sidneygasoto/QIDI-XPRO-Rebuild/05_Metrology/source/CONTINUE.md

# Development Rules

- Analyze the architecture before editing.
- Keep changes minimal.
- Avoid duplicated code.
- Prefer existing abstractions.
- Do not modify public APIs without justification.
- Update documentation when behavior changes.
- Keep compatibility with Klipper.
