sidneygasoto/QIDI-XPRO-Rebuild/08_Fotos/Bed_Level_numerado.png

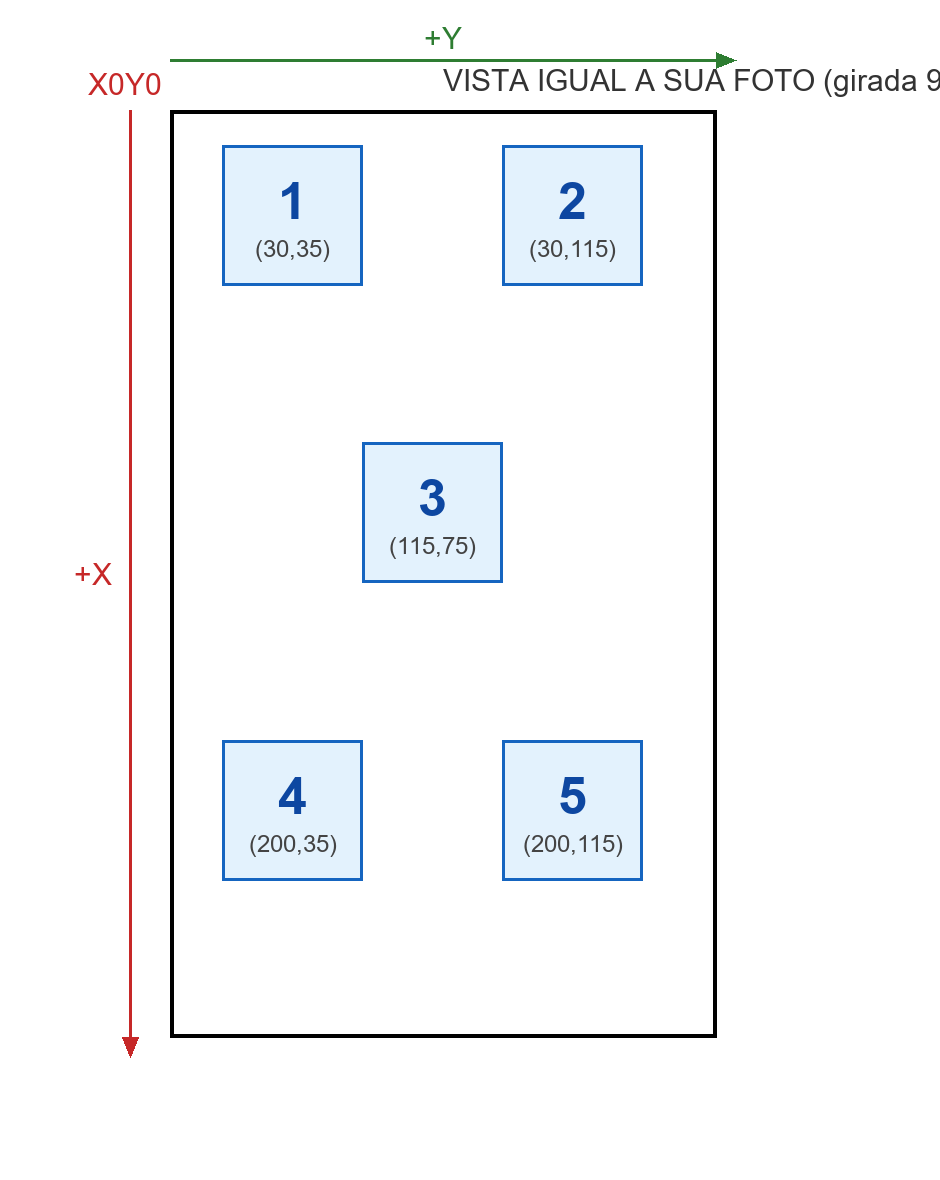
08_Fotos/Bed_Level_numerado.png
