sidneygasoto/QIDI-XPRO-Rebuild/08_Fotos/Diag pin.jpeg

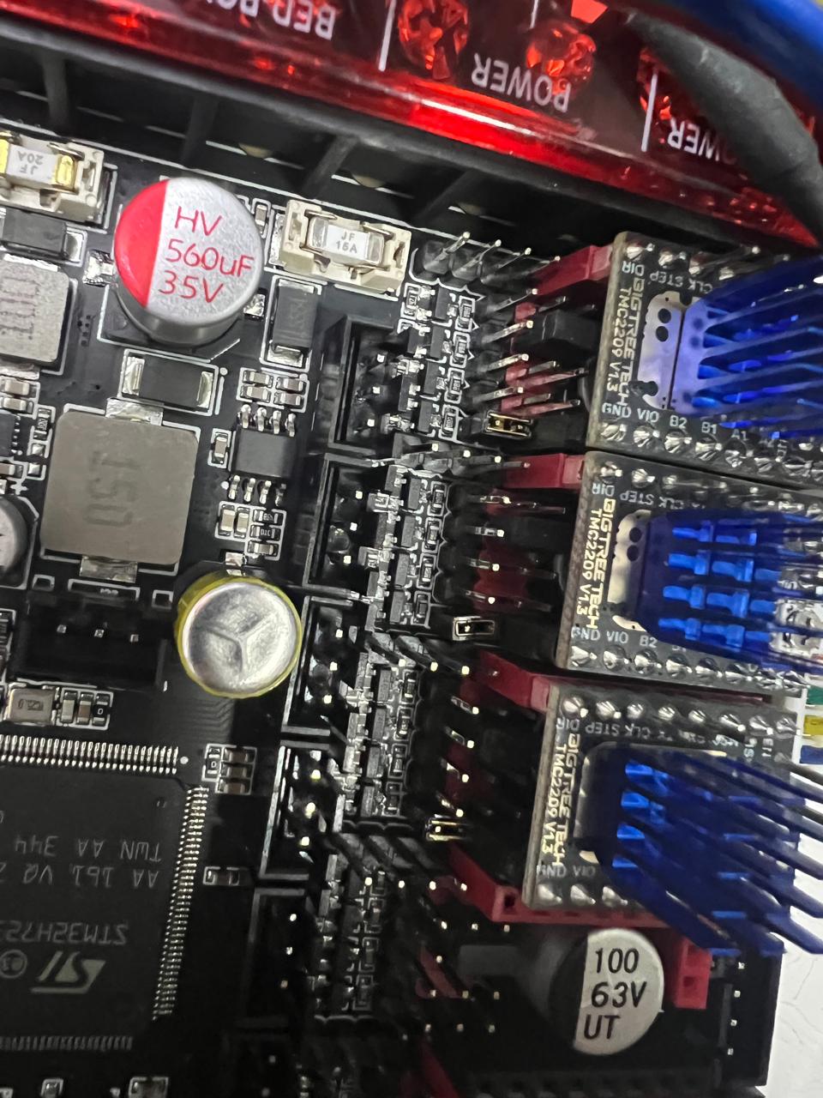
08_Fotos/Diag pin.jpeg
