sidneygasoto/QIDI-XPRO-Rebuild/08_Fotos/MB_BTT_CB1_detalhe.jpeg

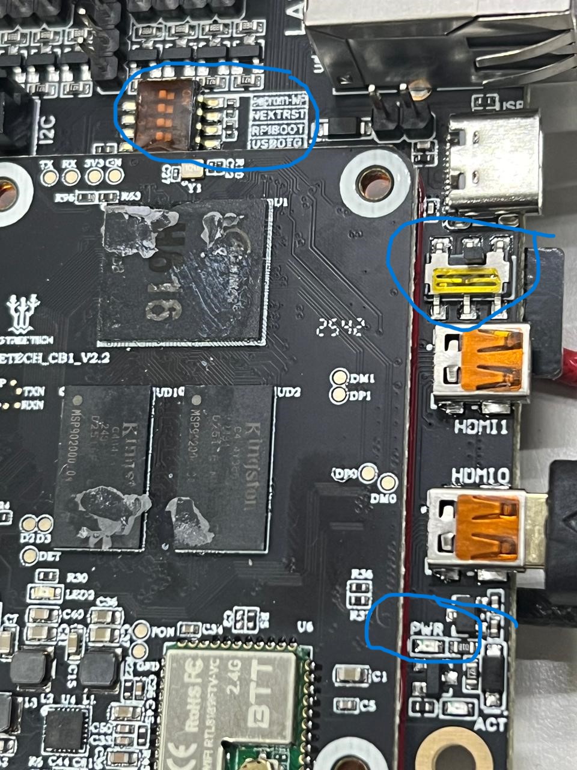
08_Fotos/MB_BTT_CB1_detalhe.jpeg
