sidneygasoto/QIDI-XPRO-Rebuild/04_STL/Nozzle temperature test.3mf

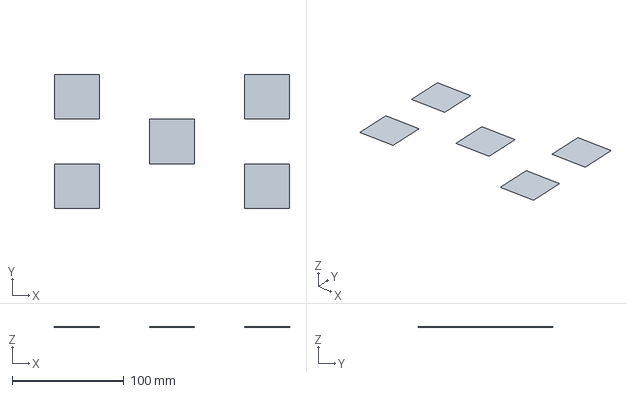
[picture p6: CAD file, 2026-10-27]
04_STL/Nozzle temperature test.3mf
210.0 x 120.0 x 0.2 mm
