sidneygasoto/QIDI-XPRO-Rebuild/04_STL/Bed_Level_1x40x40_0.2mm.stl

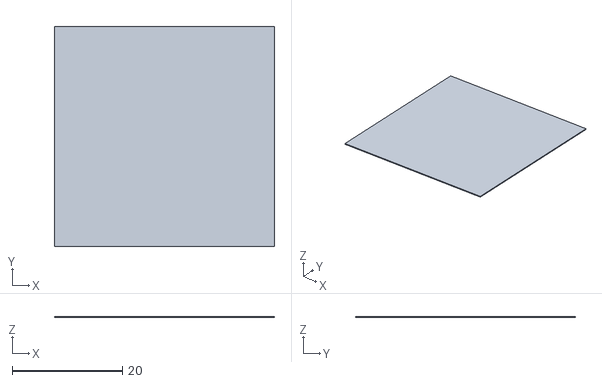
[picture p7: CAD file, 2026-10-26]
04_STL/Bed_Level_1x40x40_0.2mm.stl
40.0 x 40.0 x 0.2
