sidneygasoto/QIDI-XPRO-Rebuild/(list of files, cad)

Other CAD files:
04_STL/Bed_Level_5x40x40_0.2mm.stl
