sidneygasoto/QIDI-XPRO-Rebuild/13_Camera/04_Testing.md

# Testes

## Objetivo

Registrar os testes executados durante a implantação da câmera, bem como os respectivos resultados e validações.

---

## Conteúdo

Esta etapa documentará:

- Testes de compilação;
- Testes de inicialização;
- Testes do serviço;
- Testes de integração;
- Testes de streaming;
- Validação final.

---

## Status

> Em desenvolvimento.
