sidneygasoto/QIDI-XPRO-Rebuild/03_Klipper_Config/printer.cfg

########################################
# QIDI X-Pro Retrofit
# BIGTREETECH Manta M8P V2.0
# Klipper
########################################


########################################
# Includes
########################################

[include fluidd.cfg]
[include qidi_xpro/steppers.cfg]
[include qidi_xpro/tmc2209.cfg]
[include qidi_xpro/extruders.cfg]
[include qidi_xpro/heaters.cfg]
[include qidi_xpro/fans.cfg]
[include qidi_xpro/adxl345.cfg]
[include qidi_xpro/tools.cfg]
[include qidi_xpro/macros.cfg]
[include qidi_xpro/lights.cfg]
[include qidi_xpro/probe.cfg]
[include qidi_xpro/bed_mesh.cfg]
[include qidi_xpro/power.cfg]
[include qidi_xpro/filament.cfg]
#[include qidi_xpro/metrology.cfg]

[exclude_object]

########################################
# MCU
########################################

[mcu]
serial: /dev/serial/by-id/usb-Klipper_stm32h723xx_34002F000A51333231343036-if00

########################################
# Printer
########################################

[printer]

kinematics: cartesian

max_velocity: 600
max_accel: 10000

max_z_velocity: 25
max_z_accel: 1000

[extruder1]
#control: pid
#pid_Kp: 23.451
#pid_Ki: 1.839
#pid_Kd: 74.751

[heater_bed]
#control: pid
#pid_Kp: 73.294
#pid_Ki: 3.152
#pid_Kd: 426.020

[include moonraker_obico_macros.cfg]

#*# <---------------------- SAVE_CONFIG ---------------------->
#*# DO NOT EDIT THIS BLOCK OR BELOW. The contents are auto-generated.
#*#
#*# [input_shaper]
#*# shaper_type_x = 3hump_ei
#*# shaper_freq_x = 67.2
#*# shaper_type_y = ei
#*# shaper_freq_y = 37.2
#*#
#*# [extruder]
#*# control = pid
#*# pid_kp = 25.531
#*# pid_ki = 2.659
#*# pid_kd = 61.274
#*#
#*# [extruder1]
#*# control = pid
#*# pid_kp = 24.271
#*# pid_ki = 1.881
#*# pid_kd = 78.275
#*#
#*# [heater_bed]
#*# control = pid
#*# pid_kp = 72.591
#*# pid_ki = 3.361
#*# pid_kd = 391.989
#*#
#*# [probe]
#*# z_offset = 0.900
#*#
#*# [bed_mesh default]
#*# version = 1
#*# points =
#*# 	  -0.540000, -0.395000, -0.317500, -0.330000, -0.202500, -0.235000, -0.325000
#*# 	  -0.492500, -0.347500, -0.280000, -0.192500, -0.192500, -0.220000, -0.235000
#*# 	  -0.540000, -0.402500, -0.280000, -0.302500, -0.185000, -0.232500, -0.310000
#*# 	  -0.550000, -0.420000, -0.340000, -0.222500, -0.222500, -0.245000, -0.285000
#*# 	  -0.657500, -0.485000, -0.350000, -0.360000, -0.237500, -0.257500, -0.392500
#*# x_count = 7
#*# y_count = 5
#*# mesh_x_pps = 2
#*# mesh_y_pps = 2
#*# algo = bicubic
#*# tension = 0.2
#*# min_x = 40.0
#*# max_x = 253.0
#*# min_y = 30.0
#*# max_y = 154.0
