sidneygasoto/QIDI-XPRO-Rebuild/03_Klipper_Config/qidi_xpro/tmc2209.cfg

########################################
# QIDI X-Pro Retrofit
# TMC2209 UART Configuration
# BIGTREETECH Manta M8P V2.0
########################################


[tmc2209 stepper_x]
uart_pin: PC13
run_current: 0.700
hold_current: 0.250
stealthchop_threshold: 999999
#stealthchop_threshold: 0
#diag_pin: PF4
#driver_SGTHRS: 55

[tmc2209 stepper_y]
uart_pin: PE3
run_current: 0.700
hold_current: 0.250
stealthchop_threshold: 999999
#stealthchop_threshold: 0
#diag_pin: PF3
#driver_SGTHRS: 60

[tmc2209 stepper_z]
uart_pin: PB9
run_current: 0.650
hold_current: 0.200
stealthchop_threshold: 999999

[tmc2209 extruder]
uart_pin: PB5
run_current: 0.600
hold_current: 0.250
stealthchop_threshold: 0


[tmc2209 extruder1]
uart_pin: PG14
run_current: 0.600
hold_current: 0.250
stealthchop_threshold: 0
