sidneygasoto/QIDI-XPRO-Rebuild/03_Klipper_Config/qidi_xpro/probe.cfg

########################################
# AECO M8 PNP Probe
########################################

[probe]
pin: ^PD8

# Ajustaremos depois
x_offset: 18
y_offset: 11
#z_offset: 0.205

speed: 5

samples: 5
samples_result: median

samples_tolerance: 0.030
samples_tolerance_retries: 3

sample_retract_dist: 3

lift_speed: 15
