sidneygasoto/QIDI-XPRO-Rebuild/03_Klipper_Config/fluidd.cfg

########################################
# Fluidd Support
########################################

[virtual_sdcard]
path: /opt/3dprinter/printer_data/gcodes

[pause_resume]

[display_status]

[gcode_macro CANCEL_PRINT]
description: Cancel the current print
rename_existing: BASE_CANCEL_PRINT
gcode:
    TURN_OFF_HEATERS
    CLEAR_PAUSE
    SDCARD_RESET_FILE
    BASE_CANCEL_PRINT
