sidneygasoto/QIDI-XPRO-Rebuild/03_Klipper_Config/qidi_xpro/fans.cfg

########################################
# QIDI X-Pro Retrofit
# Fans Configuration
# BIGTREETECH Manta M8P V2.0
########################################


########################################
# Part Cooling Fan
########################################
[fan]
pin: PF6

########################################
# Hotend 0 Cooling Fan
########################################
[heater_fan hotend_fan_0]
pin: PF7
heater: extruder
heater_temp: 50.0

########################################
# Hotend 1 Cooling Fan
########################################
[heater_fan hotend_fan_1]
pin: PF9
heater: extruder1
heater_temp: 50.0
