sidneygasoto/QIDI-XPRO-Rebuild/07_Backup/config_2026-07-28_v0.2.5/machine-snapshot/qidi_xpro/tools.cfg

[gcode_macro T0]
gcode:
    ACTIVATE_EXTRUDER EXTRUDER=extruder
    SET_GCODE_OFFSET X=0 Y=0 Z=0

[gcode_macro T1]
gcode:
    ACTIVATE_EXTRUDER EXTRUDER=extruder1
    SET_GCODE_OFFSET X=33.600 Y=-0.640 Z=-0.080
