sidneygasoto/QIDI-XPRO-Rebuild/(commit log)

2026-07-07 docs: add initial project documentation and Backup_0
    [generic-bigtreetech-manta-m8p-V2_0.cfg]
2026-07-09 Atualização de docs
2026-07-09 Add validated Klipper configuration and Manta firmware artifacts
    [extruders.cfg, fans.cfg, heaters.cfg, printer.cfg, steppers.cfg, tmc2209.cfg]
2026-07-09 v0.2.0 complete Klipper Moonraker Fluidd stack
2026-07-21 v0.1.0 - Base funcional do retrofit QIDI X-Pro
    [adxl345.cfg, extruders.cfg, fans.cfg, heaters.cfg, printer.cfg, probe.cfg, steppers.cfg, tmc2209.cfg]
2026-07-24 docs(camera): add camera-streamer documentation structure
2026-07-24 docs(camera): document camera-streamer systemd service
2026-07-28 v0.2.0 - Machine geometry and dual nozzle calibration
    [adxl345.cfg, extruders.cfg, fans.cfg, fluidd.cfg, heaters.cfg, metrology.cfg, printer.cfg, probe.cfg]
2026-10-25 docs(v0.3.0): consolidar configuração real e estado verificado da máquina
    - espelha a configuração ativa da CB1 em 03_Klipper_Config/ (15 arquivos + MANIFEST)
    - move a árvore pré-calibração para 07_Backup/config_v0.1.0_2026-07/
    - recupera a árvore de cb7f9fc em 07_Backup/config_v0.2.5_2026-07-28/
    - preserva a extensão de metrologia e a proveniência em 05_Metrology/
    - reescreve 00_Estado_Atual, CHANGELOG, releases, README e Roadmap como v0.3.0
    - adiciona .gitattributes para evitar conversão de EOL nas configs espelhadas
2026-10-25 chore(gitignore): corrigir padrão de ignore do 12_BKP_chat
    O padrão anterior (.12_BKP_chat/) exigia um arquivo com ponto inicial e não ignorava nada. Agora 12_BKP_chat/ é efetivamente ignorado e *.swp vindo do remoto foi preservado.
2026-10-25 chore(backup): consolidar snapshots de julho e corrigir EOL
    - unifica config_v0.2.5_2026-07-28 e config_v0.2.0 em
    07_Backup/config_2026-07-28_v0.2.5/{commit-tree,machine-snapshot}
    - reconstrói os snapshots a partir dos blobs do git com core.autocrlf=false:
    as cópias anteriores estavam em CRLF e não eram fiéis ao commit
    - verifica fidelidade por git hash-object contra os blobs de origem
    - atualiza as referências de caminho em 00_Estado_Atual e CHANGELOG
2026-10-25 docs(mesh): registrar diagnóstico do bed mesh e corrigir afirmação sobre limites
    - adiciona 01_Docs/07_Bed_Mesh.md com a análise geométrica do perfil salvo
    - corrige a alegação de que mesh_max excedia position_max: mesh_min/max são
    coordenadas da sonda (bed_mesh.py:824 e probe.py:474), não do bico
    - registra que o perfil está inerte (sem BED_MESH* nos logs) e vencido
    (anterior ao re-nivelamento mecânico da mesa)
    - atualiza referências em 00_Estado_Atual, Roadmap, 03_Klipper_Config e PROVENANCE
2026-10-25 fix(mesh): recalibrar a malha a quente e corrigir limites da sonda
    - PROBE_ACCURACY: faixa 12,5 um (sigma 3,7 um); samples_tolerance 0.010 -> 0.030
    - borda Y mapeada: a sonda deixa a chapa entre 157 e 161; mesh_max 165 -> 154
    - malha refeita 7x5 com mesh_max 253,154 e gravada em SAVE_CONFIG
    - amplitude 0,988 -> 0,417 mm; inclinacao Y 0,534 -> 0,134 mm/100 mm
    - espelho da configuracao e MANIFEST atualizados (15/15 conferem)
2026-10-26 fix(probe): revalidar z_offset com papel e aplicar a malha no PRINT_START
    - PROBE_CALIBRATE a 80 C: z_offset 0,652 -> 0,515 mm (primeira camada
    vinha 0,137 mm baixa desde o re-nivelamento)
    - malha refeita com o offset novo e gravada em SAVE_CONFIG
    - PRINT_START carrega BED_MESH_PROFILE LOAD=default apos M190
    - espelho da configuracao e MANIFEST atualizados (15/15)
2026-10-26 feat(stl): adicionar teste de primeira camada em 5 pontos
    - 5 pastilhas de 40x40x0.2 mm em X 25..235 / Y 22..142
    - posicionadas dentro da area coberta pela malha (bico 22..235 / 19..143)
    para nao medir extrapolacao de borda
    - README com fatiamento e criterio de avaliacao
2026-10-26 feat(purge): purgar cada hotend na primeira ativacao durante a impressao
    - tools.cfg: _PURGE_STATE, PURGE_LINE e logica em T0/T1
    - a purga ocorre uma unica vez por ferramenta e somente se ela estiver aquecida
    - PRINT_START reinicia o estado; PRINT_END encerra
    - independente do fatiador: vale para Orca, PrusaSlicer ou arquivo avulso
2026-10-26 chore(config): sincronizar printer.cfg apos SAVE_CONFIG do PID; incluir STL de pastilha unica
2026-10-26 chore(stl): versionar o projeto 3mf do teste e tratar 3mf/stl como binarios
2026-10-26 chore(config): sincronizar printer.cfg apos SAVE_CONFIG com z_offset 0,550 e malha
2026-10-27 chore(config): registrar nova referencia de Z (position_endstop 158,4) e diagrama numerado das pastilhas
2026-10-27 docs(energia): nota de ligacao do rele BTT V1.2 na Manta M8P V2.0
    - diagrama com rede, rele, fonte, Manta e CB1
    - controle pelo GPIO da CB1 (pino 40 / PC8), nao pelo PS_ON da Manta:
    o MCU fica energizado pela mesma fonte, o que impediria o corte limpo
    - tabela ponto a ponto, cuidados (rele liga por padrao, janela de 15-20 s)
    e plano de teste de 8 passos
2026-10-27 docs(energia): explicar como ligar a impressora e o risco de loop de boot na janela de 15-20 s
2026-10-27 docs(filamento): ligacao e configuracao dos dois sensores de fim de filamento
    - PF0 (T0) e PC15 (T1): conectores End-Stop 5/6, livres na config atual
    - duas variantes de sensor (contato seco e alimentado) com procedimento
    de medicao obrigatorio antes de ligar o sinal
    - config Klipper com pausa condicional: so pausa quando a ferramenta
    ativa fica sem filamento, evitando parar por causa do bico inativo
2026-10-27 docs(filamento): corrigir para sensor de movimento (pulsos), nao chave
    - [filament_motion_sensor] com extruder: por ferramenta, o que resolve
    a convivencia com dois bicos sem logica manual
    - deteccao tambem de travamento e patinacao, nao so fim de carretel
    - procedimento para medir a tensao do pulso e calibrar detection_length
    pelo intervalo real entre pulsos
2026-10-27 docs(filamento): identificar pinos do conector IdeaFormer e estimar detection_length pela roda dentada
2026-10-27 docs(filamento): confirmar 5V no conector END-STOP e calibrar pelo manual
    - pinout oficial: END-STOP 5 (PF0) e 6 (PC15) tem S / G / +5V, portanto o
    sensor pode ser alimentado pelo proprio conector
    - 85 pulsos em 200 mm = 2,35 mm/pulso; detection_length 12 (~5 pulsos),
    igual ao exemplo do manual
    - ressalva de nivel: pull-up ^ cobre coletor aberto; saida push-pull de 5 V
    exige divisor
    - manual do fabricante versionado em 01_Docs
2026-10-27 docs(filamento): mover manual do sensor para 10_Datasheets e referenciar no documento
2026-10-27 feat(energia): configuracao do PS_ON (PD14) para o rele BTT V1.2
    - qidi_xpro/power.cfg: output_pin ps_on_pin (PD14, value 1, shutdown_value 1)
    e macros POWER_OFF / POWER_ON
    - POWER_OFF baixa o pino e pede shutdown do host na sequencia: o
    temporizador de 15-20 s do rele e a rede de seguranca
    - documentado o risco de loop de boot (Klipper eleva PD14 em 30-40 s,
    rele espera 15-20 s) e o teste que decide isso na pratica
    - diagrama refeito para controle pelo PS-ON da Manta
2026-10-27 feat(energia): ativar PS_ON (PD14) no printer.cfg e sincronizar espelho (16 arquivos)
2026-10-27 docs(energia): registrar implantacao e teste de comutacao do PD14
2026-10-27 docs(energia): analise do firmware do rele e caminho para estender a janela
    - verificado: a BTT nao publica o codigo-fonte (192 repos listados); existe
    apenas o hex de 184 bytes, versionado aqui como baseline
    - pinagem do MCU conforme manual: P3.2 sinal, P5.5 rele, P3.3 curto,
    P3.0/P3.1 gravacao
    - leitura estatica identifica as duas constantes de espera (0x401F e 0x4C1D)
    no laco de atraso de 16 bits, mas a semantica nao esta confirmada
    - procedimento de caracterizacao em bancada com 5 V e sem rede, antes de
    qualquer gravacao
2026-10-27 feat(energia): overlay de device tree que mantem PS_ON_IN alto no boot
    - PC8 (gpiochip0 linha 72) como gpio-hog output-high, aplicado pelo
    kernel ~1 s apos iniciar, sem depender de processo de usuarios
    - mapeamento confirmado por medicao: PC8 -> H1 pino 40 (GPIO21);
    no pino 40 observou-se 0/3,3 V a 50% enquanto a linha era alternada
    - resolve o loop de boot: o sinal sobe em ~5 s, antes dos 15-20 s do rele
    - manual da CB1 versionado (tabela de pinos do conector de 200 vias)
2026-10-28 feat(energia,filamento): INITIAL_PINS=PD14 gravado no MCU e sensores ativos
    - klipper.bin recompilado com CONFIG_INITIAL_PINS="PD14": o proprio MCU
    eleva o PS_ON no boot, antes do host, dispensando o pino 40 da CB1
    - gravacao por DFU (make flash FLASH_DEVICE=...), apos a via SD nao
    funcionar; cartao foi verificado e estava correto
    - novo klipper.bin versionado (44684 B, sha256 62be0d93...); anterior
    permanece recuperavel pelo historico do git
    - filament.cfg: dois [filament_motion_sensor], PF0 (E0) e PC15 (E1),
    detection_length 12 mm (85 pulsos / 200 mm)
2026-10-28 chore(config): MANIFEST com 17 arquivos (filament.cfg incluido)
2026-10-28 docs(energia): registrar prova do INITIAL_PINS (3,3 V com Klipper parado) e remocao do overlay
2026-10-28 docs(energia): fechar o rele - testes de ciclo de energia e POWER_OFF aprovados
2026-10-28 docs(filamento): validar E0 e documentar o comportamento do motion sensor
    - condicionamento adotado: divisor 1,2k / 2k, medido 3,1 V e 0,2 V
    (margem de 0,8 V em ambos os niveis contra V_IH 2,31 e V_IL 0,99)
    - duas condicoes do Klipper que invalidam testes fora de impressao:
    o timer do sensor so roda em idle_timeout=Printing, e o runout exige
    transicao de estado (inicializa em False)
    - testes positivo e negativo do T0 aprovados
    - gcode de teste versionado em 09_Testes
2026-10-28 docs(filamento): registrar diagnostico do T1 (mecanico, PTFE) e a latencia da pausa pelo buffer do MCU
2026-10-31 docs(filamento): fechar a validacao dos dois sensores e da convivencia
    - T1 positivo (100% sem pausa) e negativo (pausa) aprovados apos a
    correcao do tubo PTFE; o defeito era mecanico, nao eletrico
    - convivencia aprovada: imprimir no T0 com o T1 sem filamento nao pausa,
    que e o que justifica a opcao extruder: por sensor
    - pausa por runout e imediata na deteccao (12 mm), mas o PAUSE executa
    so depois de escoar a fila do MCU (~18 s observados)
2026-10-31 feat(obico): camera via uStreamer e cliente moonraker-obico instalados
    - camera-streamer (ja compilado sem libav) nao decodifica nem codifica;
    servico desativado e substituido pelo ustreamer 5.4 do Debian
    - ustreamer.service: MJPEG 640x480, encoder HW, porta 8080, /stream e /snapshot
    - ffmpeg instalado para o streaming de video do Obico
    - moonraker-obico instalado manualmente (o install.sh exige sudo e o usuario
    nao tem sudo sem senha), com venv, config e unit proprios
    - printer.cfg ja tinha o include das macros; Klipper reiniciado para carregar
    - vinculacao com a conta Obico pendente (codigo gerado: b6v5t)
2026-10-31 feat(camera): camera no Fluidd e decisao pelo modo snapshot no Obico
    - [webcam qidi_xpro] no moonraker.conf apontando para o ustreamer
    (mjpgstreamer compativel), verificado em /server/webcams/list
    - documentado que o video ao vivo no app do Obico e inviavel neste
    hardware: Janus nao existe no Debian e o H616 nao tem encoder H.264
    por hardware, entao o cliente opera a 0,1 FPS
    - decisao do usuario: opcao A - snapshots para a IA, video ao vivo pelo
    navegador/Fluidd
2026-10-31 fix(camera): stream na mesma origem via nginx para o Fluidd funcionar
    - causa: o Fluidd baixa MJPEG por um Web Worker com fetch(); sendo o stream
    na porta 8080 e o app na 80, a origem difere e o uStreamer nao envia CORS
    (verificado: sem Access-Control-Allow-Origin) -> cartao mostra (error)
    - solucao: location /webcam/ no nginx com proxy_buffering off, servindo o
    uStreamer na mesma origem do Fluidd
    - moonraker.conf aponta stream/snapshot para /webcam/
    - nginx config e documentacao do porque versionadas
2026-10-31 feat(calibracao): input shaping medido e plano de calibracao do PLA
    - SHAPER_CALIBRATE com o ADXL345: X 3hump_ei 67,2 Hz, Y ei 37,2 Hz
    (0,0% de vibracao residual), gravado via SAVE_CONFIG
    - plano em 8 etapas para PLA no T0, com a ordem justificada: a malha
    precisa ser medida a 60 C porque a chapa empena com a temperatura
    (0,2 mm medidos entre frio e quente) e a malha atual e de 80 C (PETG)
2026-11-02 feat(calibracao): z_offset do PLA corrigido para 0,900 e malha re-medida
    - primeira camada como prova: +0,10 nao adere, -0,30 linhas separadas,
    -0,35 camada fechada; deslocamento incorporado com Z_OFFSET_APPLY_PROBE
    - malha re-medida a 60 C no novo referencial: -0,657 a -0,185, media -0,331
    - registrada a regra descoberta: a malha e herdeira do z_offset e precisa
    ser re-medida quando ele muda (o erro de 0,35 voltou embutido na malha)
    - gcode do teste de primeira camada versionado
2026-11-02 feat(calibracao): pressure advance do PLA Silk medido em 0,030
    - torre de 10 faixas (0.020 a 0.110) com brim; cantos retos na faixa
    de 2-4 mm e parede boa ate 6 mm, convergindo para 0,030
    - valor anterior era 0,0885 (3x maior), herdado e igual para as duas
    extrusoras; T1 fica sem valor proprio (default 0) ate ser calibrado
    - gcode da torre versionado
2026-11-02 feat(calibracao): PA 0,030 confirmado com resfriamento e licoes dos testes
    - torre refinada (0.010 a 0.045) com ventilador: sem bojo nem falha nos
    cantos; as marcas a cada 1,6 mm sao as transicoes de faixa do gcode
    - documentado que PLA exige ventilador de peca: os cubos anteriores
    colapsaram por falta de resfriamento, nao por malha ou extrusao
    - documentado que a area de impressao (220 mm) nao e o position_max (265)
    e que a malha, em coordenadas de sonda, esta correta
    - fluxo mantido em 1,00: a recalibracao do extrusor explica os +5,3%
