sidneygasoto/QIDI-XPRO-Rebuild/(notices)

Notices in the files:
README.md:
License: MIT
